lb3361/gigatron-btpluggy/v1/hw-1.0/README.md

## Lower board version 1.0 and 1.1

Version 1.0 only works when plugged into the Gigatron.
Otherwise the three floating inputs SERCLK and IE cause spurious interrupts that crash the ESP32.

Version 1.1 fixes this by using a 74LVCH244AQ20 as a level converter instead of 74LVC244AQ20.
This turned out to be a questionable idea in practice because it potentially feed 
nonsense to the bus whenever the esp reboots.
