lb3361/gigatron-btpluggy/v1/doc/adafruit-itsybitsy-esp32-pinout.pdf

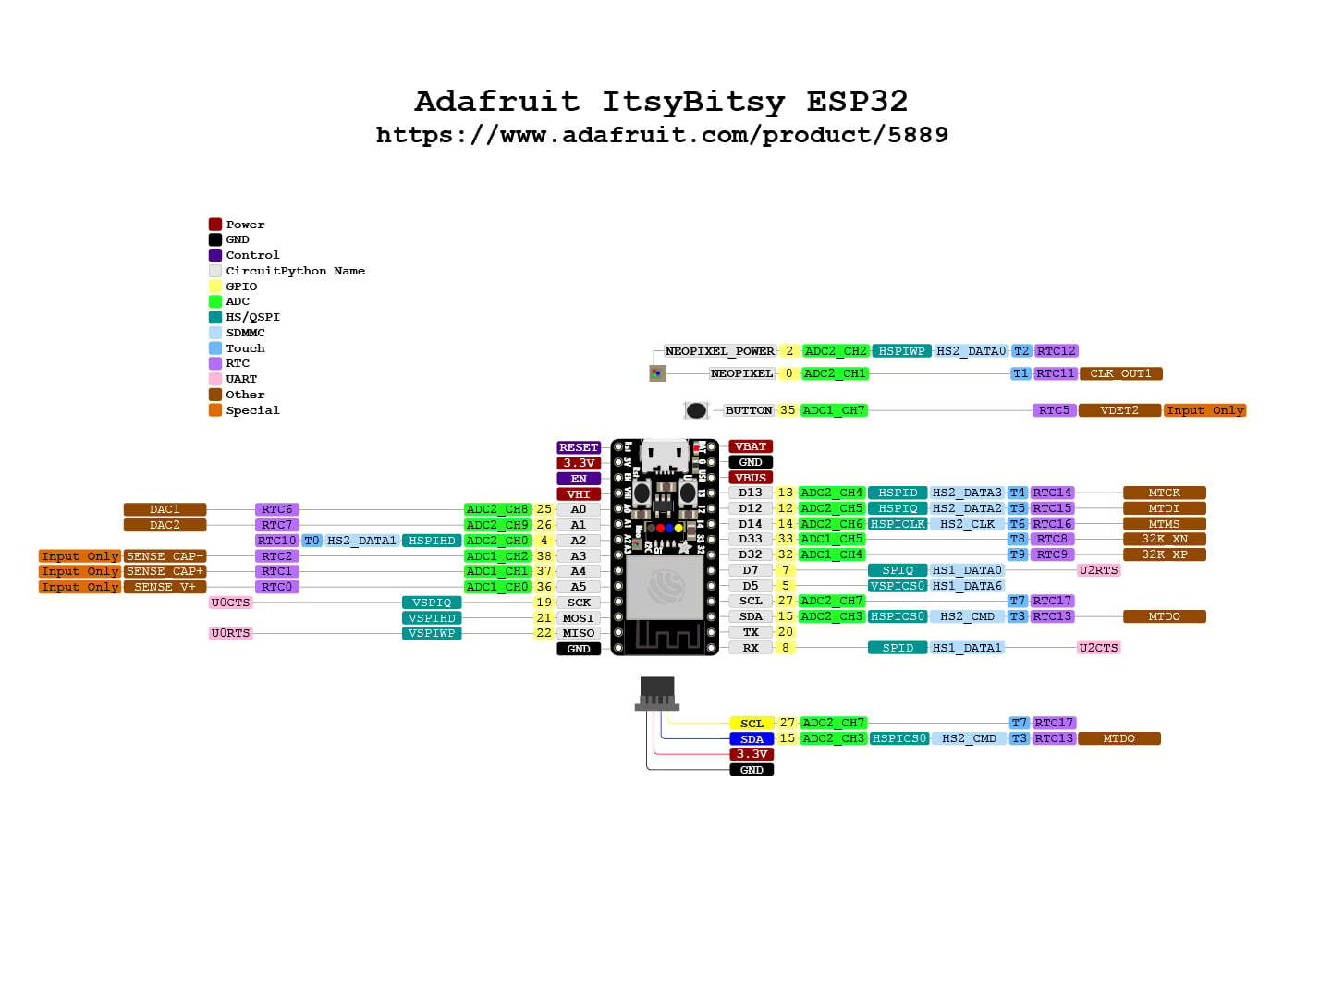
[picture p3: page 1]
