lb3361/gigatron-btpluggy/v1/hw-1.0/images/3D_PCB1.png

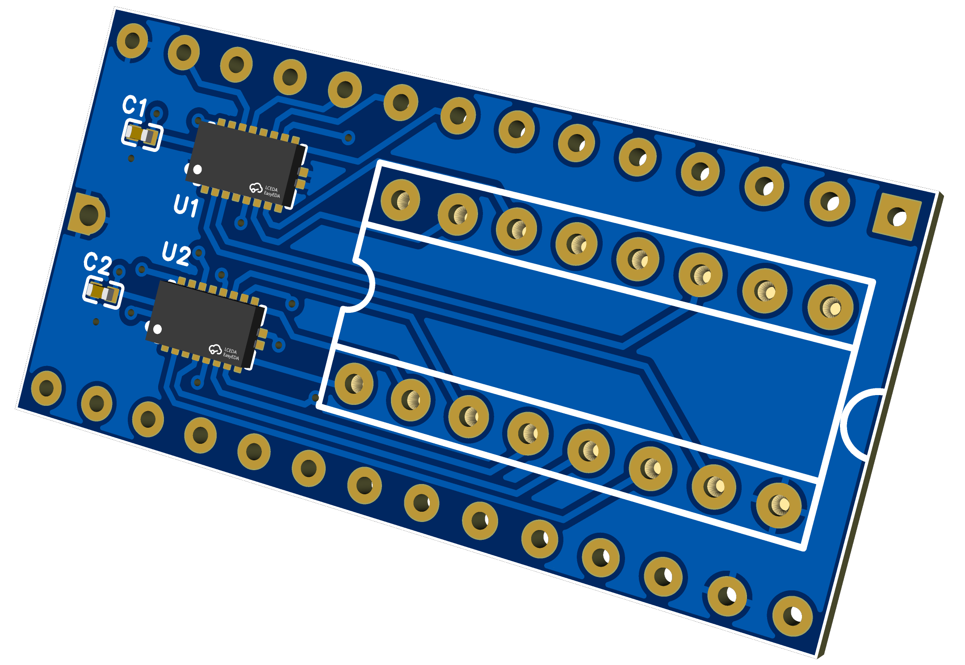
v1/hw-1.0/images/3D_PCB1.png
