lb3361/gigatron-btpluggy/v1/hw-1.0/images/img1.jpg

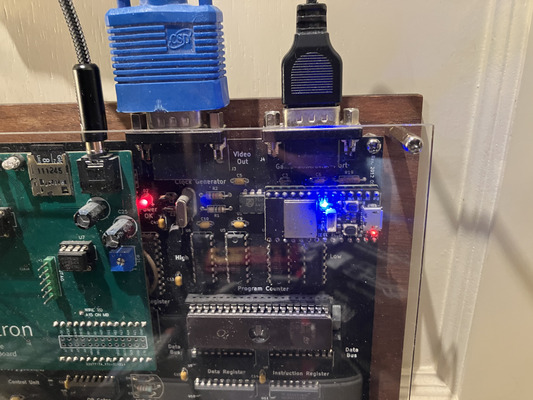
v1/hw-1.0/images/img1.jpg
