lb3361/gigatron-btpluggy/v1/hw-1.2/images/3D_PCB1.png

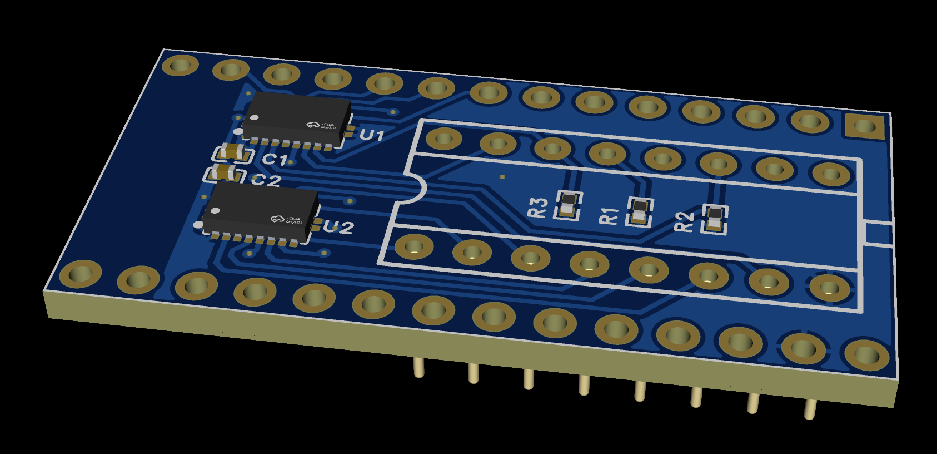
v1/hw-1.2/images/3D_PCB1.png
