lb3361/gigatron-btpluggy/v1/hw-1.2/BtPluggy-BOM.csv

No. | Quantity | Comment | Designator | Footprint | Value | Manufacturer Part | Manufacturer | Supplier Part | Supplier
1 | 2 | 100nF | C1,C2 | C0402 | 100nF | CL05B104KO5NNNC | SAMSUNG(三星) | C1525 | LCSC
2 | 3 | 33kΩ | R1,R2,R3 | R0402 | 33kΩ | 0402WGF3302TCE | UNI-ROYAL(厚声) | C25779 | LCSC
3 | 2 | 74LVC244AQ20-13 | U1,U2 | V-QFN4525-20_L4.5-W2.5-P0.50-BL |  | 74LVC244AQ20-13 | DIODES(美台) | C460536 | LCSC
