lb3361/gigatron-btpluggy/v1/hw-1.2/Schematics.pdf

+5V

V33 +5V

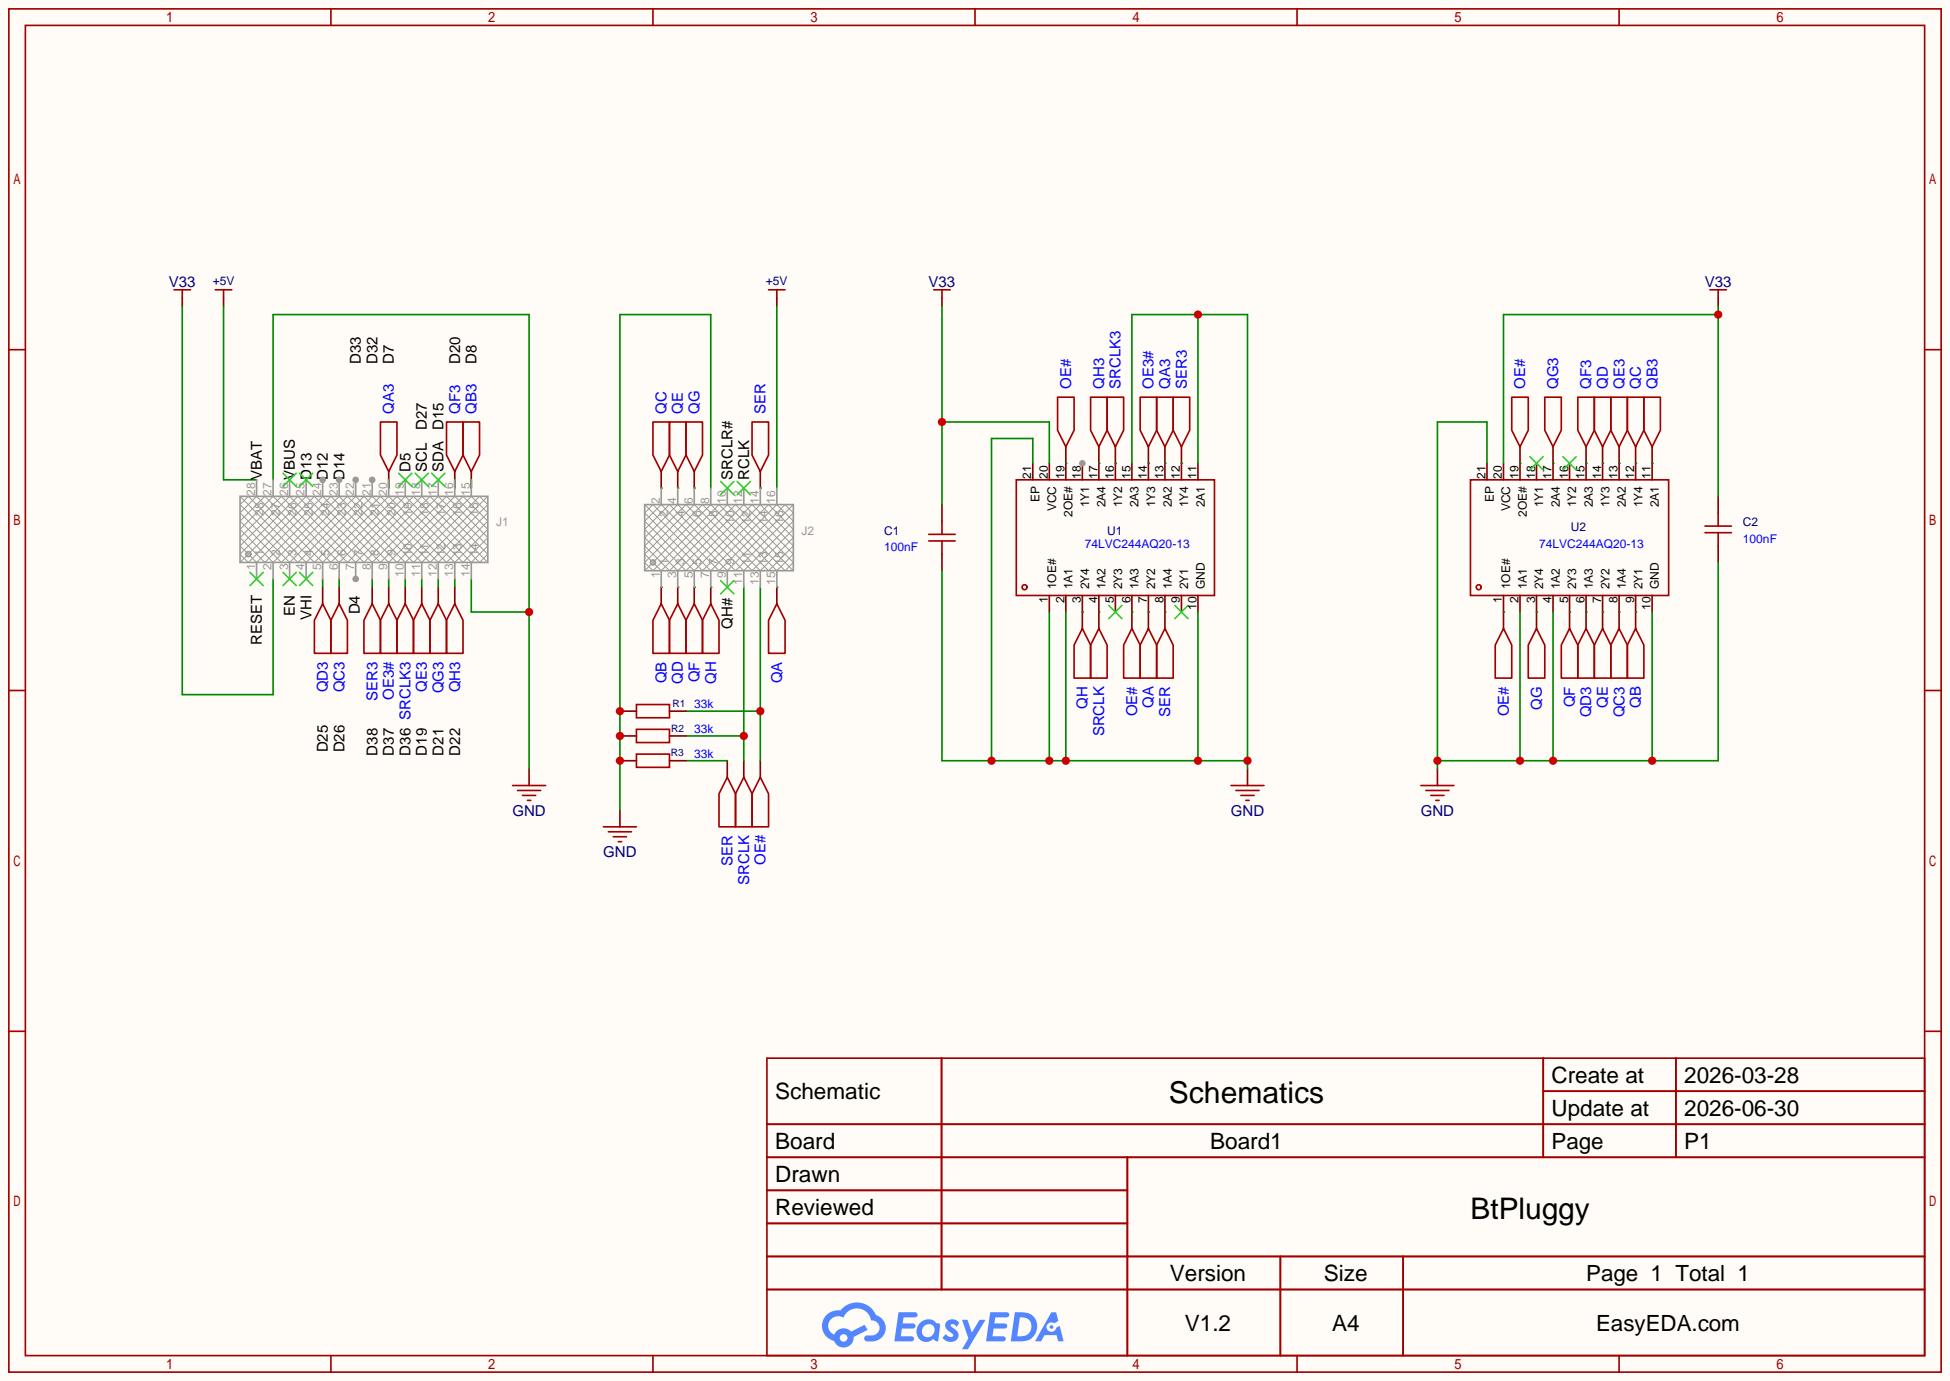
[picture p7: page 1]

Schematic | Schematics | Create at | 2026-03-28

Update at | 2026-06-30

Board | Board1 | Page | P1
Drawn | | BtPluggy
Reviewed

Version | Size | Page 1 Total 1
V1.2 | A4 | EasyEDA.com
