lb3361/gigatron-btpluggy/v1/hw-1.0/schematics.pdf

+5V

V33 +5V

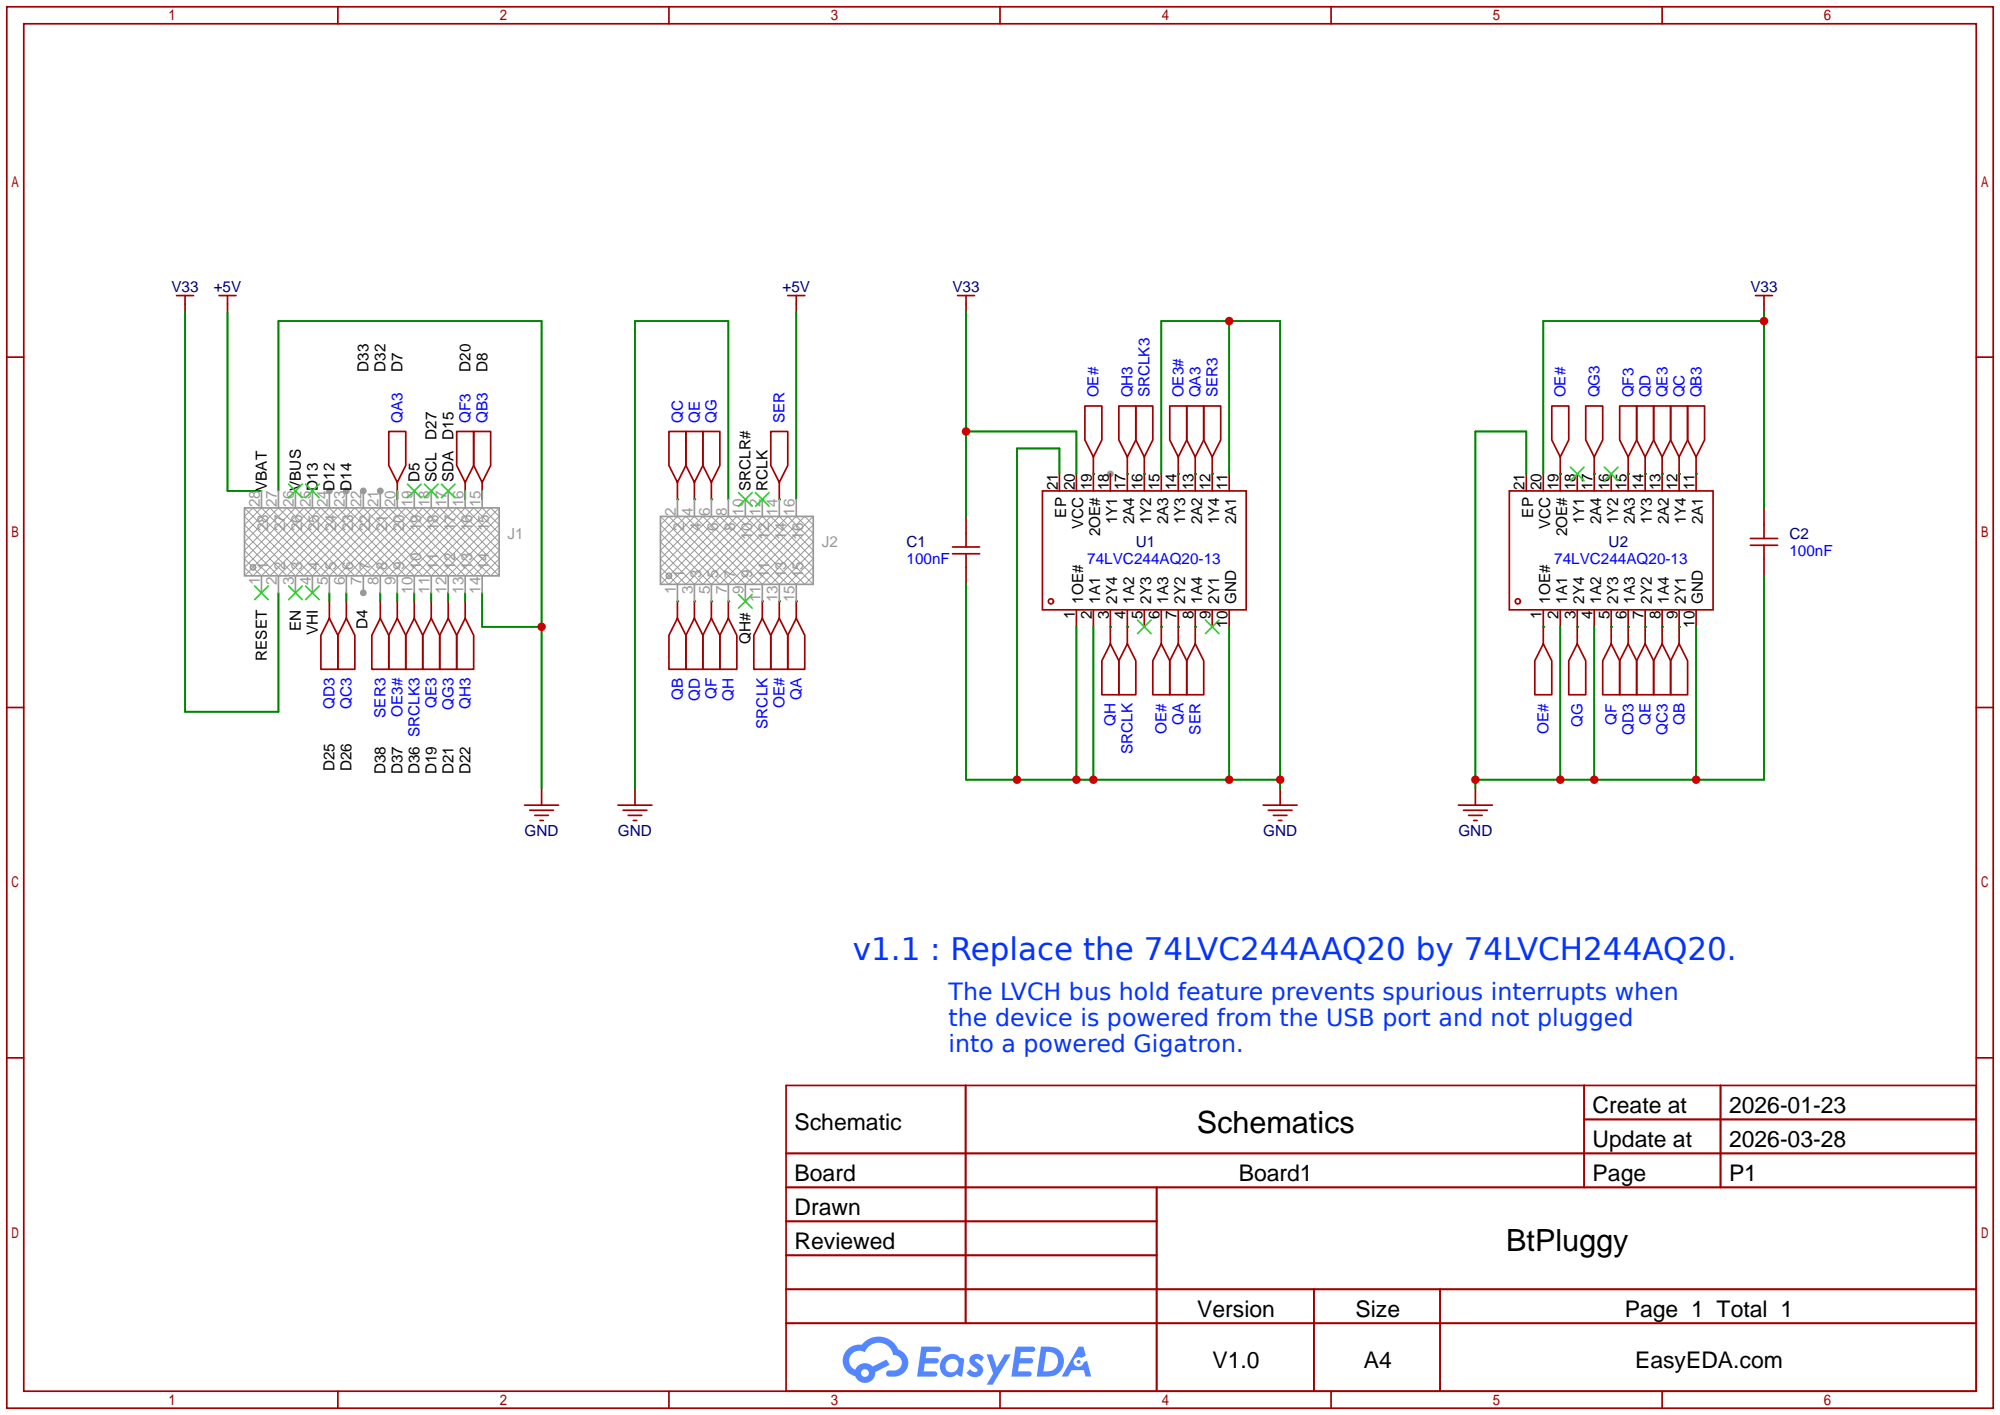
[picture p8: page 1]

Schematic | Schematics | Create at | 2026-01-23

Update at | 2026-03-28

Board | Board1 | Page | P1
Drawn | | BtPluggy
Reviewed

Version | Size | Page 1 Total 1
V1.0 | A4 | EasyEDA.com
