lb3361/gigatron-btpluggy/(list of files, drawings)

Other design files:
v1/hw-1.0/BtPluggy.epro
