lb3361/gigatron-btpluggy/(commit log)

2026-02-28 added hw info
    [BtPluggy.epro]
2026-02-28 added 3d rendering of lower board
2026-03-08 added doc, patches in schematics
2026-03-10 decode gamepad buttons as gigatron input byte.
2026-03-10 more systematic led scheduling
2026-03-30 updated hw files
    [BtPluggy-BOM.csv, BtPluggy-PickAndPlace.csv, BtPluggy.epro]
2026-04-22 track vsync with /ie interrupt
2026-04-22 keyboard ctrl+alt+del maintains start to cause a reset
    [gigatron.c, gigatron.h, keyboard.c, keymap.h]
2026-05-22 reorganizing isr code cures missed hsync (by very little) - this is still fragile because it depends on optimizing for size and on a patch to esp-idf to move the esp-hid task to cpu0.
    [gigatron.c, gigatron.h, keyboard.c, main.c, pluggy.c, pluggy.h]
2026-05-22 74hc595 emulation now works with a nmi interrupt on core1. This solves the missed hsync issues in a more reliable manner.
    [gigatron.c, gigatron.h]
2026-05-26 fix nmi handler loader frames hooks
    [gigatron.c, pluggy.c]
2026-06-01 lowered freq to 160MHz to reduce power requirements
2026-06-02 added fat partition at 0x200000 (2M) size 6M
    [partitions.csv]
2026-06-09 hw v1.1 : using 74LVCH244AAQ20 instead of LVC version
    The LVCH version has a bus hold feature that prevents
    spurious interrupts when the device is powered from USB
    while not plugged or plugged into an unpowered Gigatron.
    [BtPluggy-BOM-1.1.csv, BtPluggy-PickAndPlace-1.1.csv]
2026-06-30 added improved hardware files
    [BtPluggy-BOM-1.1.csv, BtPluggy-BOM-LVCH.csv, BtPluggy-BOM.csv, BtPluggy-PickAndPlace-1.1.csv, BtPluggy-PickAndPlace-LVCH.csv, BtPluggy-PickAndPlace.csv, BtPluggy.epro]
2026-07-10 temporary delay ble scans when a bt device is reconnecting.
2026-07-11 Reboot on last disconnect.
    [gap.c, hid.c]
2026-07-29 disabled reboot on last disconnect. enable pullup on gpios.
    [gigatron.c, hid.c]
2026-08-21 the 74lcvh244 might be less robust. more testing is needed.
    [BtPluggy-BOM-LVCH.csv, BtPluggy-PickAndPlace-LVCH.csv]
2026-09-14 gigatron.c: added code to inject loader frames
2026-11-03 switched to a single input event queue
2026-11-04 ctrl+f1 now prints help on the gigatron screen
2026-11-06 removed the suggestion to use lvch power level shifters.
2026-11-07 gigatron.c: frame checksum only chain when frames follow tightly
